yuan910715/3keys/updatepage/a3d5aa0211ee351263de6953c64a4eea.png

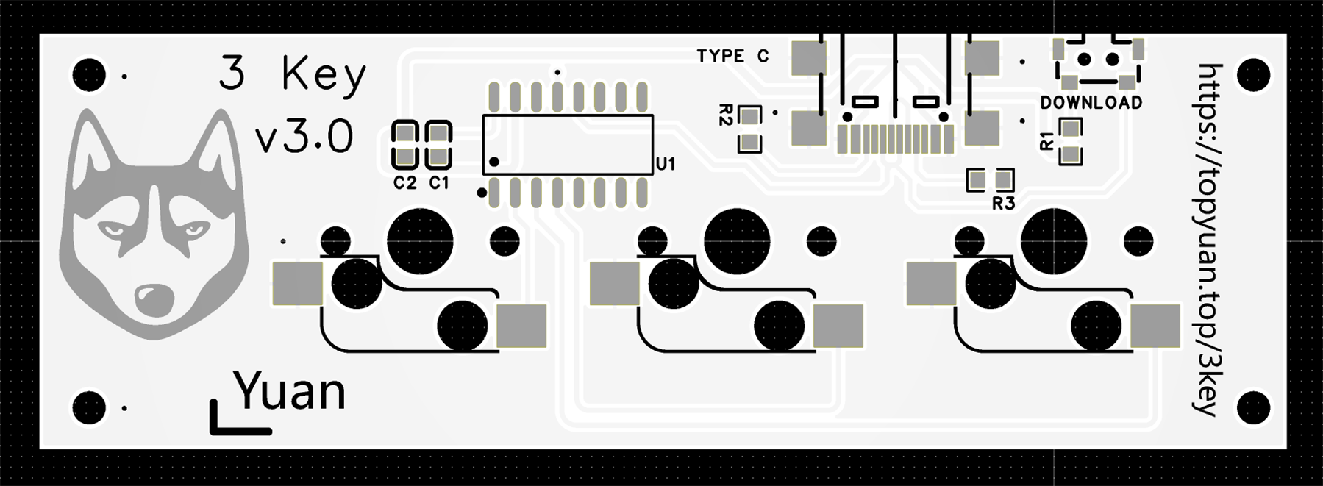
updatepage/a3d5aa0211ee351263de6953c64a4eea.png
