yuan910715/3keys/updatepage/db6b78d11dcdd43cf0e8a59821b84ef4.png

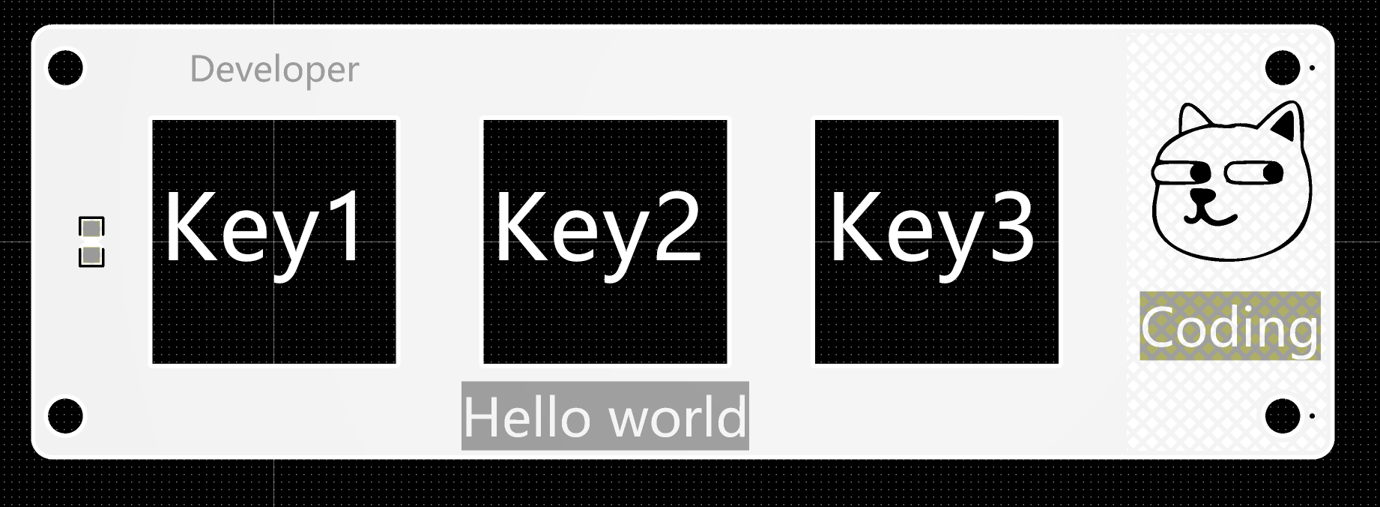
updatepage/db6b78d11dcdd43cf0e8a59821b84ef4.png
