yuan910715/3keys/WindowsFormsApp1/WindowsFormsApp1/Resources/key.png

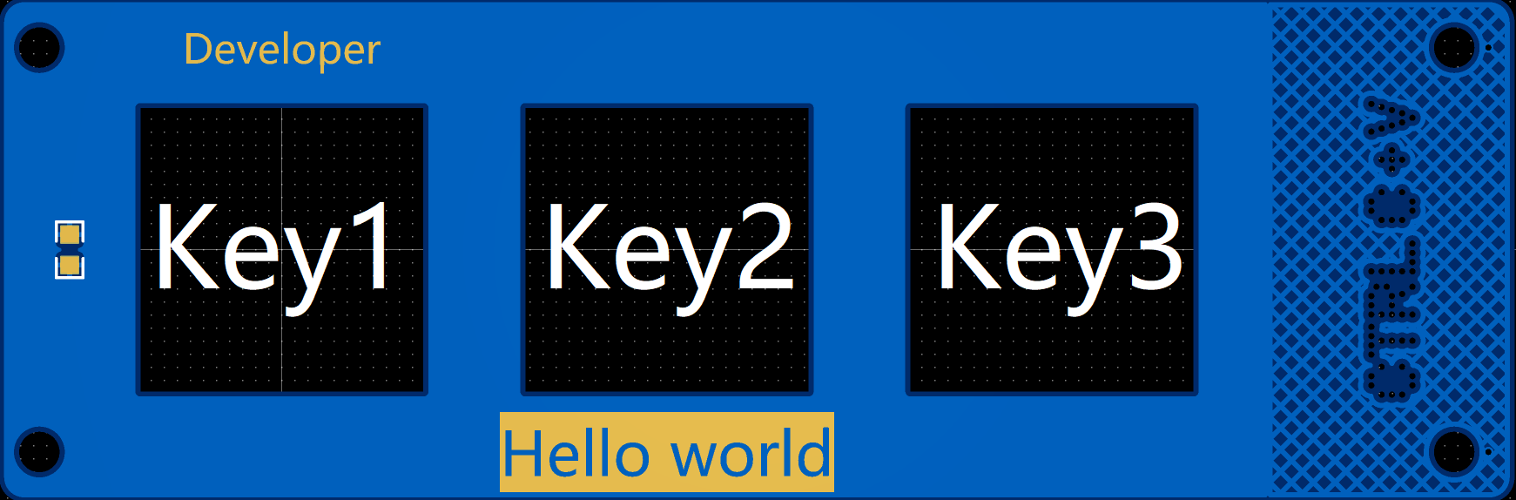
WindowsFormsApp1/WindowsFormsApp1/Resources/key.png
