yuan910715/3keys/(threads)

Thread 1 (2023-03-30):

v4固件下的小键盘，无法通过usb-hub连接电脑

louis16s, 2023-03-30:
排除了type-c线的问题，同样的扩展坞，上一版的固件可以直接使用
v4固件的则没有反应

yuan910715, 2023-03-30:
使用 USB A to C 数据线 还是 C to C 数据线？
不适用扩展坞可否正常连接？

> 排除了type-c线的问题，同样的扩展坞，上一版的固件可以直接使用 v4固件的则没有反应

louis16s, 2023-03-30:
使用a 2 c，直连笔记本可用

Have a nice day
  r祺
________________________________
发件人: MonsterYuan ***@***.***>
发送时间: Thursday, March 30, 2023 4:44:11 PM
收件人: yuan910715/3keys ***@***.***>
抄送: louis16s ***@***.***>; Author ***@***.***>
主题: Re: [yuan910715/3keys] v4固件下的小键盘，无法通过usb-hub连接电脑 (Issue #1)

使用 USB A to C 数据线 还是 C to C 数据线？
不适用扩展坞可否正常连接？

排除了type-c线的问题，同样的扩展坞，上一版的固件可以直接使用 v4固件的则没有反应

―
Reply to this email directly, view it on GitHub<https://github.com/yuan910715/3keys/issues/1#issuecomment-1489923920>, or unsubscribe<https://github.com/notifications/unsubscribe-auth/ANVAEDCFSRCCCYG7Y6EBP2TW6VBVXANCNFSM6AAAAAAWM6YPVQ>.
You are receiving this because you authored the thread.Message ID: ***@***.***>

yuan910715, 2023-03-30:
使用扩展坞连接后, web改键页能否连接设备？ https://topyuan.top/3key

louis16s, 2023-03-30:
抱歉，打扰了
经过多次试验，现在成功通过hub连上了键盘
原因未知
给您带来不便，敬请谅解

Have a nice day
  r祺
________________________________
发件人: MonsterYuan ***@***.***>
发送时间: Thursday, March 30, 2023 4:53:54 PM
收件人: yuan910715/3keys ***@***.***>
抄送: louis16s ***@***.***>; Author ***@***.***>
主题: Re: [yuan910715/3keys] v4固件下的小键盘，无法通过usb-hub连接电脑 (Issue #1)

使用扩展坞连接后, web改键页能否连接设备？ https://topyuan.top/3key

―
Reply to this email directly, view it on GitHub<https://github.com/yuan910715/3keys/issues/1#issuecomment-1489937573>, or unsubscribe<https://github.com/notifications/unsubscribe-auth/ANVAEDDEQ3H2OPUPFGUWZBLW6VC2FANCNFSM6AAAAAAWM6YPVQ>.
You are receiving this because you authored the thread.Message ID: ***@***.***>

yuan910715, 2023-03-30:
插上USB线后 需要等待2秒再操作键盘
如果刚插上就立刻按键 会导致键盘按键不可用，但此时改键可正常连接. 这个问题原因未知。怀疑是这个问题导致。

yuan910715, 2023-04-25:
>
V4.1已解决此问题
https://github.com/DeqingSun/ch55xduino/issues/132

Closed 2023-03-30.

Thread 2 (2023-04-30):

请教一下HID的问题

hanbingniao, 2023-04-30:
你好！从deqingsun大大的issues看到了您，正好也是做类似的东西，然后看到那个cdc的项目是声明的HID键盘，但是我想用媒体键盘，但是对HID不太熟u，改了一下午，请教一下那个reportID要怎么改呀？现在合并完了虽然能编译但是按键用不了，看到您实现了，想请教一下，谢谢！

yuan910715, 2023-05-04:
看下我的代码， 是CDC+多媒体键盘的。就是reportID要和desc里的对应就行

hanbingniao, 2023-07-07:
仔细研究了一下，非常感谢！！
最近也在做ch552的小键盘，算是单片机初学，还有有很多不懂的哈哈哈
然后能在我的项目里用一下您的src的文件吗？谢谢！

yuan910715, 2023-07-17:
>

可以

Closed 2023-07-17.

Thread 5 (2023-07-16):

HID键盘扩展请求

Zylsjsp, 2023-07-16:
你好 从立创广场一路看到这来的 很不错的3键键盘固件！

我自己的出发点是想要做一个单独的Sysreq单键键盘 开源广场上也看了很多方案 感觉各路神仙都把ch552玩出花来

我读了@DeqingSun的示例代码和你的项目 基于我自己的使用场景 想给功能键增加一个sysreq的选项 也查了相关的hid规范pdf
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
感觉只要在`USBHIDKeyboard.c`修改`#DEFINE`和`app.vue`里面的列表应该就能加入新的键位 板子和材料还没到所以我暂时还不能验证可行性 如果可行的话看看能不能接受一下我的PR

可以的话能不能尝试对HID里面的其他键进行扩展呢 比如留一部分自定义功能键`0xfc-0xfe`可以提供给自定义的映射 至少有三个键的空间可以用 如果可以把这三个键在web改键程序上作为自定义扩展提供应该会更加方便（例如需要改PrintScr, Pause键的场景）

yuan910715, 2023-07-17:
添加按键很容易，USBHIDKeyboard.c里可以不修改。
Sysreq按键是什么作用？我查了资料现代键盘已没有此键位  部分操作系统将其解析成PrintScreen ，你是想要添加PrintScreen按键吗？

Zylsjsp, 2023-07-17:
Sysreq的功能可以参考内核文档[Linux Magic System Request Key Hacks](https://www.kernel.org/doc/html/latest/admin-guide/sysrq.html)

有一部分键盘厂商是将printsrc和sysreq做到一个键上的 但是这个方法不在USB HID的规范中 同时这个键的位置在表里的位置太靠后了 @DeqingSun提供的示例代码中给出的+136的映射区域不能够直接找到HID中后半部分的键（中间`0xb5`我记得也是一个跳过去的映射 因为和'~'冲突吧好像） 看看是不是有机会可以考虑重构一下这部分代码完整支持HID keyboard的完整表

另外 这个键盘支持6键无冲吗 如果不支持的话是不是最好也做一个适配

yuan910715, 2023-07-20:
我在改键页增加了printscr/break pause/num lock/scroll lock四个按键， sysreq我再研究下。 CH552 IO够 可以6键无冲不需要添加其他元件。

Thread 6 (2023-07-17):

代码

Mr-ShiYi, 2023-07-17:
请问，v5.1码源能发一下吗，我想改个连接名称

Zylsjsp, 2023-07-17:
@yuan910715 看了一下commit记录 可以考虑去了解一下git的使用方法 本地git仓库修改了之后可以git push和GitHub同步 省去单独上传的麻烦了

命令行工具不好上手的话可以考虑一下vscode git插件 非常直观好用

yuan910715, 2023-07-20:
5.1源码已上传。

> 请问，v5.1码源能发一下吗，我想改个连接名称

yuan910715, 2023-07-20:
> @yuan910715 看了一下commit记录 可以考虑去了解一下git的使用方法 本地git仓库修改了之后可以git push和GitHub同步 省去单独上传的麻烦了
>
> 命令行工具不好上手的话可以考虑一下vscode git插件 非常直观好用

公司的网络有限制，git push跑不了 我就直接web页面上传了。

Mr-ShiYi, 2023-07-20:
好的，谢谢

Mr-ShiYi, 2023-07-20:
> 5.1源码已上传。
>
> > 请问，v5.1码源能发一下吗，我想改个连接名称

@yuan910715 请问0x0317和0x030e两个代码什么意思，我知道0x0316是改连接名称的
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

yuan910715, 2023-07-20:
>

是CDC的描述信息 但windows不会显示

Mr-ShiYi, 2023-07-20:
好的，谢谢，那我可以不管他，只改0316

Closed 2023-07-20.

Thread 7 (2023-07-20):

dataflash数据存储问题

LUCA-5342, 2023-07-20:
您好，我注意到CH552G芯片内置的dataflash只有128K，dedingsun的eeprom.h中也描述到if (addr >= 128) {
    return;
  }，看您的板子并没有增加外置存储，想请问您是如何做到eeprom读写到152地址的呢，是否能更多？
顺带一提，把鼠标加进来太棒了，可惜源码中并没有~

yuan910715, 2023-07-20:
您好 纠正一下CH552G芯片内置的dataflash是128字节 不是128K  之前我没注意到 所以有大于128的 实际重新插拔USB线后这部分设置就丢失了-_-||
我把最新源码上传了 包含鼠标部分了。
现在保存设置很多项是按1字节保存 实际用不了这么多  改为按位拼接保存 会省一些空间。

LUCA-5342, 2023-07-20:
感谢回答，之前就想做这个，但一直没有时间，最近抽空鼓捣了一下，结果需要近300字节的eeprom才够，查看报文发现128之后开始循环了，准备考虑一下按位拼接保存！

Closed 2023-08-04.

Thread 9 (2023-10-21):

大佬，我代码有点不懂，指导一下，谢谢

Mr-ShiYi, 2023-10-21:
请问，按键判断条件代码我有点不懂，能不能跟我解释一下，就是if的判断条件不是很懂，我试着代进去，还是，有一点弯没转过来
图片是示例里来的，
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

Mr-ShiYi, 2023-10-21:
@yuan910715 有空就帮我指导一下，谢谢

yuan910715, 2023-10-25:
就是判断按键按下或弹起状态有没有改变

yuan910715, 2023-10-25:
`bool button1PressPrev = false;`
button1PressPrev在loop外定义 值为false  表示key1默认状态为弹起状态。 此变量用于标识按键上次改变后的状态。

`bool button1Press = !digitalRead(BUTTON1_PIN);`
button1Press表示key1当前状态 弹起为false 按下为true  ，digitalRead读取按键1的引脚值（HIGH或LOW  (1/0) ）由于硬件上key1的键盘轴连接对应引脚和GND  且引脚配置了内部上拉 参考setup()中：pinMode(BUTTON1_PIN, INPUT_PULLUP);   所以digitalRead读取此引脚 当键盘轴弹起状态为HIGH(1-true) ， 按下为LOW(0-false)  取反后，键盘弹起为false 按下为true

if里就是用key1上次改变后的状态button1PressPrev和当前状态button1Press判断 不等于时表明状态发生改变。

Mr-ShiYi, 2023-10-25:
就是布尔值button1PressPrev = false是一个记录按键上一次状态
比如button1PressPrev = false，按下按钮当前状态取反为ture，两者不相等，执行if，将当前状态赋予button1PressPrev = false变为ture

yuan910715, 2023-10-25:
是的 就是这意思

Mr-ShiYi, 2023-10-25:
谢谢，懂了，还有就是，我想加键的话，代码按照上面示例加就行是吧，相当于固定输出，不能自定义按键

yuan910715, 2023-10-25:
是的

Mr-ShiYi, 2023-10-25:
好的，谢谢指导

Closed 2023-10-25.

Thread 12 (2024-04-26):

HID按键2个问题？

wuqi716, 2024-04-26:
1、请教楼主，XP,WIN7系统不装驱动都支持吗？

2、如果按键按下状态（一直按着），怎么能每1秒循环发送键值？请教楼主

yuan910715, 2024-04-26:
WIN 7试过，键盘可用，改键需要安装USB CDC驱动，XP没有试过。
Keyboard_press和Keyboard_release分别为按键按下、释放方法，如果一直按着，操作系统会控制一直输出相应按键，如果想手动每隔1秒触发一次，延时控制就行。

wuqi716, 2024-04-26:
收到，谢谢，改键需要安装USB CDC驱动意思是在电脑上安装，还是在Arduino里插入代码编译生成HEX程序？&nbsp;

吴先生
***@***.***

&nbsp;

------------------&nbsp;原始邮件&nbsp;------------------
发件人: ***@***.***&gt;;
发送时间: 2024年4月26日(星期五) 上午10:23
收件人: ***@***.***&gt;;
抄送: ***@***.***&gt;; ***@***.***&gt;;
主题: Re: [yuan910715/3keys] HID按键2个问题？ (Issue #12)

WIN 7试过，键盘可用，改键需要安装USB CDC驱动，XP没有试过。
 Keyboard_press和Keyboard_release分别为按键按下、释放方法，如果一直按着，操作系统会控制一直输出相应按键，如果想手动每隔1秒触发一次，延时控制就行。

—
Reply to this email directly, view it on GitHub, or unsubscribe.
You are receiving this because you authored the thread.Message ID: ***@***.***&gt;

yuan910715, 2024-04-26:
需要在WIN 7的PC上安装USB CDC驱动，否则可能不会识别USB串口设备，导致改键页面不能搜到设备

wuqi716, 2024-04-26:
收到，谢谢，我试试

&nbsp;

吴先生
***@***.***

&nbsp;

------------------&nbsp;原始邮件&nbsp;------------------
发件人: ***@***.***&gt;;
发送时间: 2024年4月26日(星期五) 上午10:32
收件人: ***@***.***&gt;;
抄送: ***@***.***&gt;; ***@***.***&gt;;
主题: Re: [yuan910715/3keys] HID按键2个问题？ (Issue #12)

需要在WIN 7的PC上安装USB CDC驱动，否则可能不会识别USB串口设备，导致改键页面不能搜到设备

—
Reply to this email directly, view it on GitHub, or unsubscribe.
You are receiving this because you authored the thread.Message ID: ***@***.***&gt;

Closed 2024-04-26.

Thread 13 (2024-06-14):

编译失败

xiaoWangSec, 2024-06-14:
```
Linking everything together...
"C:\\Users\\Administrator\\AppData\\Local\\Arduino15\\packages\\CH55xDuino\\tools\\MCS51Tools\\2023.10.10/win/busybox" ash "C:\\Users\\Administrator\\AppData\\Local\\Arduino15\\packages\\CH55xDuino\\tools\\MCS51Tools\\2023.10.10/wrapper/sdcc-link.sh" "C:\\Users\\Administrator\\AppData\\Local\\Arduino15\\packages\\CH55xDuino\\tools\\sdcc\\build.13407_4/bin/sdcc" --nostdlib "-LC:\\Users\\Administrator\\AppData\\Local\\Temp\\arduino\\sketches\\33BDE724B82CB71055F8934B06EEDA5C" "-LC:\\Users\\Administrator\\AppData\\Local\\Arduino15\\packages\\CH55xDuino\\tools\\sdcc\\build.13407_4/lib/large_int_calc_stack_auto" --code-size 14336 --xram-size 876 --xram-loc 148 -mmcs51 -DCH552 "C:\\Users\\Administrator\\AppData\\Local\\Temp\\arduino\\sketches\\33BDE724B82CB71055F8934B06EEDA5C\\sketch\\threekey.ino.cpp.o" "C:\\Users\\Administrator\\AppData\\Local\\Temp\\arduino\\sketches\\33BDE724B82CB71055F8934B06EEDA5C\\sketch\\src\\CDC_KEYBOARD\\USBCDC.c.o" "C:\\Users\\Administrator\\AppData\\Local\\Temp\\arduino\\sketches\\33BDE724B82CB71055F8934B06EEDA5C\\sketch\\src\\CDC_KEYBOARD\\USBHIDKeyboard.c.o" "C:\\Users\\Administrator\\AppData\\Local\\Temp\\arduino\\sketches\\33BDE724B82CB71055F8934B06EEDA5C\\sketch\\src\\CDC_KEYBOARD\\USBconstant.c.o" "C:\\Users\\Administrator\\AppData\\Local\\Temp\\arduino\\sketches\\33BDE724B82CB71055F8934B06EEDA5C\\sketch\\src\\CDC_KEYBOARD\\USBhandler.c.o" "C:\\Users\\Administrator\\AppData\\Local\\Temp\\arduino\\sketches\\33BDE724B82CB71055F8934B06EEDA5C/core\\core.a" -lmcs51 -llibsdcc -lliblong -lliblonglong -llibint -llibfloat --out-fmt-ihx -o "C:\\Users\\Administrator\\AppData\\Local\\Temp\\arduino\\sketches\\33BDE724B82CB71055F8934B06EEDA5C/threekey.ino.elf"

?ASlink-Error-Insufficient ROM/EPROM/FLASH memory.
"C:\\Users\\Administrator\\AppData\\Local\\Arduino15\\packages\\CH55xDuino\\tools\\sdcc\\build.13407_4/bin/avr-objcopy_7_3_0" -O ihex -R DATA -R INITIALIZED -R SSEG "C:\\Users\\Administrator\\AppData\\Local\\Temp\\arduino\\sketches\\33BDE724B82CB71055F8934B06EEDA5C/threekey.ino.elf" "C:\\Users\\Administrator\\AppData\\Local\\Temp\\arduino\\sketches\\33BDE724B82CB71055F8934B06EEDA5C/threekey.ino.hex"
C:\Users\Administrator\AppData\Local\Arduino15\packages\CH55xDuino\tools\sdcc\build.13407_4/bin/avr-objcopy_7_3_0: 'C:\Users\Administrator\AppData\Local\Temp\arduino\sketches\33BDE724B82CB71055F8934B06EEDA5C/threekey.ino.elf': No such file

exit status 1

Compilation error: exit status 1

```

xiaoWangSec, 2024-06-14:
安装0.0.16版本的CH55x开发板成功编译

Closed 2024-06-14.

Thread 14 (2024-07-11):

关于换行符的问题

sanbrother, 2024-07-11:
请问下，在网页上，可以在字符串后面添加换行符吗？
比如说HELLO\n，结果会把\n输出，而不是期待的换行

谢谢

yuan910715, 2024-07-12:
已增加，请帮助测试

sanbrother, 2024-07-14:
收到，非常感谢。测试后反馈结果

sanbrother, 2024-07-14:
> 已增加，请帮助测试
确认完成，非常好用。您增加的回车选项真的方便，我原本以为会处理成转义符，那样还真挺麻烦。
感谢您开源的作品，太好用了

sanbrother, 2024-07-14:
再次感谢

Closed 2024-07-14.

Thread 15 (2024-07-31):

关于数字锁定，滚轮锁定和空格键的问题

Mr-ShiYi, 2024-07-31:
你好，我在ch552的例程库文件里没有看见关于这三个按键，能告诉我是哪个对应这三个按键吗

yuan910715, 2024-07-31:
Scroll Lock : 0xCF
Num Lock : 0xDB
空格键是ASCII码0x20

Mr-ShiYi, 2024-07-31:
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
请问，怎么利用这个程序使用这些按键，直接用ascl码吗

yuan910715, 2024-07-31:
参考Keyboard_press(0x20)

Mr-ShiYi, 2024-07-31:
在那可以看正确的ASCLL码，我在网上搜的对应不上

Closed 2024-07-31.

Thread 16 (2024-11-01):

关于模拟鼠标

BD3OOX, 2024-11-01:
ok

BD3OOX, 2024-11-05:
@ @ @

yuan910715, 2024-11-05:
你好 没复现问题 请详细描述一下设置过程

BD3OOX, 2024-11-05:
第一次:设置成 鼠标 长按按住鼠标,保存
第二次,鼠标 向上移动,保存
第三次,改回第一次的配置
这样就变成长按+移动了

yuan910715, 2024-11-05:
已修复，请重新刷入7.0测试

BD3OOX, 2024-11-05:
实际一直有个问题,没多问,github下载的hex固件,WCHISP都会提示hex转bin失败,从你网站下的没事,我自己编译的也没事

Closed 2024-11-12.

Thread 17 (2025-03-18):

固件烧写问题

sanbrother, 2025-03-18:
今天尝试烧写V7版本的固件，WCHISPStudio提示目标文件HEX转BIN失败
使用hex2bin转换成bin后，烧写成功了

以前烧写hex文件是没有问题的，奇怪了。尝试了V6版本也不行

yuan910715, 2025-03-18:
你好，不能烧录的hex是github里的吗？
请试下https://topyuan.top/3key/howtoupdate 下载的hex是否可以正常烧录

sanbrother, 2025-03-19:
> 你好，不能烧录的hex是github里的吗？ 请试下https://topyuan.top/3key/howtoupdate 下载的hex是否可以正常烧录
噢，github里面带的不好用。howtoupdate里面的OK，谢谢

yuan910715, 2025-03-19:
> > 你好，不能烧录的hex是github里的吗？ 请试下https://topyuan.top/3key/howtoupdate 下载的hex是否可以正常烧录
>
> 噢，github里面带的不好用。howtoupdate里面的OK，谢谢

我把github的压缩了一下 应该没问题了 你可以试试 不知道为什么hex不行  感谢!

Closed 2025-03-19.

Thread 18 (2025-03-26):

库中的代码，在我本地编译不过求帮忙。

humanpp, 2025-03-26:
FQBN: CH55xDuino:mcs51:ch552:usb_settings=user148
Using board 'ch552' from platform in folder: C:\Users\users1\AppData\Local\Arduino15\packages\CH55xDuino\hardware\mcs51\0.0.23
Using core 'ch55xduino' from platform in folder: C:\Users\users1\AppData\Local\Arduino15\packages\CH55xDuino\hardware\mcs51\0.0.23

Detecting libraries used...
C:\Users\users1\AppData\Local\Arduino15\packages\CH55xDuino\tools\MCS51Tools\2023.10.10/win/busybox ash C:\Users\users1\AppData\Local\Arduino15\packages\CH55xDuino\tools\MCS51Tools\2023.10.10/wrapper/sdcc.sh C:\Users\users1\AppData\Local\Arduino15\packages\CH55xDuino\tools\sdcc\build.13407_4/bin/sdcc C:\Users\users1\AppData\Local\arduino\sketches\02FDFFE97B6386BD774A75BC1CEE9C95\sketch\threekey.ino.cpp nul re12 -c -Ddouble=float -DUSE_STDINT -D__PROG_TYPES_COMPAT__ --model-large --int-long-reent -E -MC -mmcs51 -DCH552 -DF_CPU=24000000L -DF_EXT_OSC=0L -DARDUINO=10607 -DARDUINO_ch55x -DARDUINO_ARCH_MCS51 -DUSER_USB_RAM=148 -IC:\Users\users1\AppData\Local\Arduino15\packages\CH55xDuino\hardware\mcs51\0.0.23\cores\ch55xduino -IC:\Users\users1\AppData\Local\Arduino15\packages\CH55xDuino\hardware\mcs51\0.0.23\variants\ch552 -IC:\Users\users1\AppData\Local\Arduino15\packages\CH55xDuino\tools\sdcc\build.13407_4/include
Using cached library dependencies for file: C:\Users\users1\AppData\Local\arduino\sketches\02FDFFE97B6386BD774A75BC1CEE9C95\sketch\src\CDC_KEYBOARD\USBCDC.c
Using cached library dependencies for file: C:\Users\users1\AppData\Local\arduino\sketches\02FDFFE97B6386BD774A75BC1CEE9C95\sketch\src\CDC_KEYBOARD\USBHIDKeyboard.c
Using cached library dependencies for file: C:\Users\users1\AppData\Local\arduino\sketches\02FDFFE97B6386BD774A75BC1CEE9C95\sketch\src\CDC_KEYBOARD\USBconstant.c
Using cached library dependencies for file: C:\Users\users1\AppData\Local\arduino\sketches\02FDFFE97B6386BD774A75BC1CEE9C95\sketch\src\CDC_KEYBOARD\USBhandler.c
Generating function prototypes...
C:\Users\users1\AppData\Local\Arduino15\packages\CH55xDuino\tools\MCS51Tools\2023.10.10/win/busybox ash C:\Users\users1\AppData\Local\Arduino15\packages\CH55xDuino\tools\MCS51Tools\2023.10.10/wrapper/sdcc.sh C:\Users\users1\AppData\Local\Arduino15\packages\CH55xDuino\tools\sdcc\build.13407_4/bin/sdcc C:\Users\users1\AppData\Local\arduino\sketches\02FDFFE97B6386BD774A75BC1CEE9C95\sketch\threekey.ino.cpp C:\Users\users1\AppData\Local\Temp\3940619350\sketch_merged.cpp re12 -c -Ddouble=float -DUSE_STDINT -D__PROG_TYPES_COMPAT__ --model-large --int-long-reent -E -MC -mmcs51 -DCH552 -DF_CPU=24000000L -DF_EXT_OSC=0L -DARDUINO=10607 -DARDUINO_ch55x -DARDUINO_ARCH_MCS51 -DUSER_USB_RAM=148 -IC:\Users\users1\AppData\Local\Arduino15\packages\CH55xDuino\hardware\mcs51\0.0.23\cores\ch55xduino -IC:\Users\users1\AppData\Local\Arduino15\packages\CH55xDuino\hardware\mcs51\0.0.23\variants\ch552 -IC:\Users\users1\AppData\Local\Arduino15\packages\CH55xDuino\tools\sdcc\build.13407_4/include
C:\Users\users1\AppData\Local\Arduino15\packages\builtin\tools\ctags\5.8-arduino11/ctags -u --language-force=c++ -f - --c++-kinds=svpf --fields=KSTtzns --line-directives C:\Users\users1\AppData\Local\Temp\3940619350\sketch_merged.cpp
Compiling sketch...
"C:\\Users\\users1\\AppData\\Local\\Arduino15\\packages\\CH55xDuino\\tools\\MCS51Tools\\2023.10.10/win/busybox" ash "C:\\Users\\users1\\AppData\\Local\\Arduino15\\packages\\CH55xDuino\\tools\\MCS51Tools\\2023.10.10/wrapper/sdcc.sh" "C:\\Users\\users1\\AppData\\Local\\Arduino15\\packages\\CH55xDuino\\tools\\sdcc\\build.13407_4/bin/sdcc" "C:\\Users\\users1\\AppData\\Local\\arduino\\sketches\\02FDFFE97B6386BD774A75BC1CEE9C95\\sketch\\threekey.ino.cpp" "C:\\Users\\users1\\AppData\\Local\\arduino\\sketches\\02FDFFE97B6386BD774A75BC1CEE9C95\\sketch\\threekey.ino.cpp.o" re2 -MMD -c -Ddouble=float -DUSE_STDINT -D__PROG_TYPES_COMPAT__ --model-large --int-long-reent --less-pedantic -mmcs51 -DCH552 -DF_CPU=24000000L -DF_EXT_OSC=0L -DARDUINO=10607 -DARDUINO_ch55x -DARDUINO_ARCH_MCS51 -DUSER_USB_RAM=148 "-IC:\\Users\\users1\\AppData\\Local\\Arduino15\\packages\\CH55xDuino\\hardware\\mcs51\\0.0.23\\cores\\ch55xduino" "-IC:\\Users\\users1\\AppData\\Local\\Arduino15\\packages\\CH55xDuino\\hardware\\mcs51\\0.0.23\\variants\\ch552" "-IC:\\Users\\users1\\AppData\\Local\\Arduino15\\packages\\CH55xDuino\\tools\\sdcc\\build.13407_4/include"
Using previously compiled file: C:\Users\users1\AppData\Local\arduino\sketches\02FDFFE97B6386BD774A75BC1CEE9C95\sketch\src\CDC_KEYBOARD\USBconstant.c.o
Using previously compiled file: C:\Users\users1\AppData\Local\arduino\sketches\02FDFFE97B6386BD774A75BC1CEE9C95\sketch\src\CDC_KEYBOARD\USBhandler.c.o
Using previously compiled file: C:\Users\users1\AppData\Local\arduino\sketches\02FDFFE97B6386BD774A75BC1CEE9C95\sketch\src\CDC_KEYBOARD\USBHIDKeyboard.c.o
Using previously compiled file: C:\Users\users1\AppData\Local\arduino\sketches\02FDFFE97B6386BD774A75BC1CEE9C95\sketch\src\CDC_KEYBOARD\USBCDC.c.o
Compiling libraries...
Compiling core...
Using precompiled core: C:\Users\users1\AppData\Local\arduino\cores\aadd0a0b637199e1f6a6e80db97698d7\core.a
Linking everything together...
"C:\\Users\\users1\\AppData\\Local\\Arduino15\\packages\\CH55xDuino\\tools\\MCS51Tools\\2023.10.10/win/busybox" ash "C:\\Users\\users1\\AppData\\Local\\Arduino15\\packages\\CH55xDuino\\tools\\MCS51Tools\\2023.10.10/wrapper/sdcc-link.sh" "C:\\Users\\users1\\AppData\\Local\\Arduino15\\packages\\CH55xDuino\\tools\\sdcc\\build.13407_4/bin/sdcc" --nostdlib "-LC:\\Users\\users1\\AppData\\Local\\arduino\\sketches\\02FDFFE97B6386BD774A75BC1CEE9C95" "-LC:\\Users\\users1\\AppData\\Local\\Arduino15\\packages\\CH55xDuino\\tools\\sdcc\\build.13407_4/lib/large_int_calc_stack_auto" --code-size 14336 --xram-size 876 --xram-loc 148 -mmcs51 -DCH552 "C:\\Users\\users1\\AppData\\Local\\arduino\\sketches\\02FDFFE97B6386BD774A75BC1CEE9C95\\sketch\\threekey.ino.cpp.o" "C:\\Users\\users1\\AppData\\Local\\arduino\\sketches\\02FDFFE97B6386BD774A75BC1CEE9C95\\sketch\\src\\CDC_KEYBOARD\\USBCDC.c.o" "C:\\Users\\users1\\AppData\\Local\\arduino\\sketches\\02FDFFE97B6386BD774A75BC1CEE9C95\\sketch\\src\\CDC_KEYBOARD\\USBHIDKeyboard.c.o" "C:\\Users\\users1\\AppData\\Local\\arduino\\sketches\\02FDFFE97B6386BD774A75BC1CEE9C95\\sketch\\src\\CDC_KEYBOARD\\USBconstant.c.o" "C:\\Users\\users1\\AppData\\Local\\arduino\\sketches\\02FDFFE97B6386BD774A75BC1CEE9C95\\sketch\\src\\CDC_KEYBOARD\\USBhandler.c.o" "C:\\Users\\users1\\AppData\\Local\\arduino\\sketches\\02FDFFE97B6386BD774A75BC1CEE9C95/..\\..\\cores\\aadd0a0b637199e1f6a6e80db97698d7\\core.a" -lmcs51 -llibsdcc -lliblong -lliblonglong -llibint -llibfloat --out-fmt-ihx -o "C:\\Users\\users1\\AppData\\Local\\arduino\\sketches\\02FDFFE97B6386BD774A75BC1CEE9C95/threekey.ino.elf"

?ASlink-Error-Insufficient ROM/EPROM/FLASH memory.
"C:\\Users\\users1\\AppData\\Local\\Arduino15\\packages\\CH55xDuino\\tools\\sdcc\\build.13407_4/bin/avr-objcopy_7_3_0" -O ihex -R DATA -R INITIALIZED -R SSEG "C:\\Users\\users1\\AppData\\Local\\arduino\\sketches\\02FDFFE97B6386BD774A75BC1CEE9C95/threekey.ino.elf" "C:\\Users\\users1\\AppData\\Local\\arduino\\sketches\\02FDFFE97B6386BD774A75BC1CEE9C95/threekey.ino.hex"
C:\Users\users1\AppData\Local\Arduino15\packages\CH55xDuino\tools\sdcc\build.13407_4/bin/avr-objcopy_7_3_0: 'C:\Users\users1\AppData\Local\arduino\sketches\02FDFFE97B6386BD774A75BC1CEE9C95/threekey.ino.elf': No such file

exit status 1

Compilation error: exit status 1

问了deepseek说是内存不够？

humanpp, 2025-03-26:
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

代码就是原版未动，直接编译。

yuan910715, 2025-03-26:
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

yuan910715, 2025-03-26:
请按上图尝试调整 Tools-USB Settings值

humanpp, 2025-04-03:
多谢大佬

Closed 2025-04-03.
