yuan910715/3keys/threekey/src/CDC_KEYBOARD/USBconstant.c

#include "USBconstant.h"


//Device descriptor
__code uint8_t DevDesc[] = {
    0x12,0x01,
    0x10,0x01,  //USB spec release number in BCD format, USB1.1 (0x10, 0x01).
    0xEF,0x02,0x01, //bDeviceClass, bDeviceSubClass, bDeviceProtocol 
    DEFAULT_ENDP0_SIZE, //bNumConfigurations
    0x09,0x12,0x50,0xC5, // VID PID 
    0x01,0x01,  //version
    0x01,0x02,0x03, //bString
    0x01    //bNumConfigurations
};

__code uint16_t DevDescLen = sizeof(DevDesc);

__code uint8_t CfgDesc[] ={
    0x09,0x02,sizeof(CfgDesc) & 0xff,sizeof(CfgDesc) >> 8,
    0x03,0x01,0x00,0x80,0x64,             //Configuration descriptor (2 interfaces)
    // Interface Association Descriptor, IAD, this packes following 2 interfaces into 1
    0x08,0x0B,0x00,0x02,0x02,0x02,0x01,0x04,
    // Interface 1 (CDC) descriptor
    0x09,0x04,0x00,0x00,0x01,0x02,0x02,0x01,0x04,    // CDC control description, 1 endpoint
    // Functional Descriptor refer to usbcdc11.pdf
    0x05,0x24,0x00,0x10,0x01,                                 //Header Functional Descriptor
    0x05,0x24,0x01,0x00,0x00,                                 //Call Management Functional Descriptor
    0x04,0x24,0x02,0x02,                                      //Direct Line Management Functional Descriptor, Support: Set_Line_Coding, Set_Control_Line_State, Get_Line_Coding, Serial_State 
    0x05,0x24,0x06,0x00,0x01,                                 //Union Functional Descriptor, Communication class interface 0, Data Class Interface 1
    0x07,0x05,0x81,0x03,0x08,0x00,0x40,                       //EndPoint descriptor (CDC Upload, Interrupt)
    // Interface 2 (Data Interface) descriptor
    0x09,0x04,0x01,0x00,0x02,0x0a,0x00,0x00,0x04,             //Data Class Interface descriptor
    0x07,0x05,0x02,0x02,0x40,0x00,0x00,                       //endpoint descriptor
    0x07,0x05,0x82,0x02,0x40,0x00,0x00,                       //endpoint descriptor
     // Interface 3 (HID) descriptor
    0x09,0x04,0x02,0x00,0x01,0x03,0x01,0x01,0x00,    // HID Keyboard, 2 endpoints
    0x09,0x21,0x10,0x01,0x21,0x01,0x22,sizeof(ReportDesc) & 0xff,sizeof(ReportDesc) >> 8,    //HID Descriptor
    0x07,0x05,0x83,0x03,0x10,0x00,0x0A,                       //endpoint descriptor
   
};

__code uint16_t ReportDescLen = sizeof(ReportDesc);

__code uint8_t ReportDesc[] ={
    0x05, 0x01,                    // USAGE_PAGE (Generic Desktop)
    0x09, 0x06,                    // USAGE (Keyboard)
    0xa1, 0x01,                    // COLLECTION (Application)
 0x85, 0x01,                    //   REPORT_ID (1)
    0x05, 0x07,                    //   USAGE_PAGE (Keyboard)
    0x19, 0xe0,                    //   USAGE_MINIMUM (Keyboard LeftControl)
    0x29, 0xe7,                    //   USAGE_MAXIMUM (Keyboard Right GUI)
    0x15, 0x00,                    //   LOGICAL_MINIMUM (0)
    0x25, 0x01,                    //   LOGICAL_MAXIMUM (1)
    0x95, 0x08,                    //   REPORT_COUNT (8)
    0x75, 0x01,                    //   REPORT_SIZE (1)
    0x81, 0x02,                    //   INPUT (Data,Var,Abs)
    0x95, 0x01,                    //   REPORT_COUNT (1)
    0x75, 0x08,                    //   REPORT_SIZE (8)
    0x81, 0x03,                    //   INPUT (Cnst,Var,Abs)
    0x95, 0x06,                    //   REPORT_COUNT (6)
    0x75, 0x08,                    //   REPORT_SIZE (8)
    0x15, 0x00,                    //   LOGICAL_MINIMUM (0)
 0x26, 0xff, 0x00,              //   LOGICAL_MAXIMUM (255)
    0x05, 0x07,                    //   USAGE_PAGE (Keyboard)
    0x19, 0x00,                    //   USAGE_MINIMUM (Reserved (no event indicated))
    0x29, 0xe7,                    //   USAGE_MAXIMUM (Keyboard Right GUI)
    0x81, 0x00,                    //   INPUT (Data,Ary,Abs)
    0x05, 0x08,                    //   USAGE_PAGE (LEDs)
    0x19, 0x01,                    //   USAGE_MINIMUM (Num Lock)
    0x29, 0x05,                    //   USAGE_MAXIMUM (Kana)
    0x15, 0x00,                    //   LOGICAL_MINIMUM (0)
    0x25, 0x01,                    //   LOGICAL_MAXIMUM (1)
    0x95, 0x05,                    //   REPORT_COUNT (5)
    0x75, 0x01,                    //   REPORT_SIZE (1)
    0x91, 0x02,                    //   OUTPUT (Data,Var,Abs)
    0x95, 0x01,                    //   REPORT_COUNT (1)
    0x75, 0x03,                    //   REPORT_SIZE (3)
    0x91, 0x03,                    //   OUTPUT (Cnst,Var,Abs)
 0xc0,                          // END_COLLECTION
    0x05, 0x0c,                    // USAGE_PAGE (Consumer Devices)
    0x09, 0x01,                    // USAGE (Consumer Control)
    0xa1, 0x01,                    // COLLECTION (Application)
    0x85, 0x02,                    //   REPORT_ID (2)
    0x15, 0x00,                    //   LOGICAL_MINIMUM (0)
    0x26, 0xff, 0x03,              //   LOGICAL_MAXIMUM (1023)
    0x19, 0x00,                    //   USAGE_MINIMUM (Unassigned)
    0x2a, 0xff, 0x03,              //   USAGE_MAXIMUM (Undefined)
    0x95, 0x04,                    //   REPORT_COUNT (4)
    0x75, 0x10,                    //   REPORT_SIZE (16)
    0x81, 0x00,                    //   INPUT (Data,Ary,Abs)
    0xc0,                           // END_COLLECTION
     0x05, 0x01,                    // USAGE_PAGE (Generic Desktop)
    0x09, 0x02,                    // USAGE (Mouse)
    0xa1, 0x01,                    // COLLECTION (Application)
    0x09, 0x01,                    //   USAGE (Pointer)
    0xa1, 0x00,                    //   COLLECTION (Physical)
    0x85, 0x03,                    //   REPORT_ID (2)
    0x05, 0x09,                    //     USAGE_PAGE (Button)
    0x19, 0x01,                    //     USAGE_MINIMUM (Button 1)
    0x29, 0x03,                    //     USAGE_MAXIMUM (Button 3)
    0x15, 0x00,                    //     LOGICAL_MINIMUM (0)
    0x25, 0x01,                    //     LOGICAL_MAXIMUM (1)
    0x95, 0x03,                    //     REPORT_COUNT (3)
    0x75, 0x01,                    //     REPORT_SIZE (1)
    0x81, 0x02,                    //     INPUT (Data,Var,Abs)
    0x95, 0x01,                    //     REPORT_COUNT (1)
    0x75, 0x05,                    //     REPORT_SIZE (5)
    0x81, 0x03,                    //     INPUT (Cnst,Var,Abs)
    0x05, 0x01,                    //     USAGE_PAGE (Generic Desktop)
    0x09, 0x30,                    //     USAGE (X)
    0x09, 0x31,                    //     USAGE (Y)
    0x09, 0x38,                    //     USAGE (Wheel)
    0x15, 0x81,                    //     LOGICAL_MINIMUM (-127)
    0x25, 0x7f,                    //     LOGICAL_MAXIMUM (127)
    0x75, 0x08,                    //     REPORT_SIZE (8)
    0x95, 0x03,                    //     REPORT_COUNT (2)
    0x81, 0x06,                    //     INPUT (Data,Var,Rel)
    0xc0,                          //     END_COLLECTION
    0xc0                           // END_COLLECTION
};
__code uint16_t CfgDescLen = sizeof(CfgDesc);

//String Descriptors
__code uint8_t LangDes[]={0x04,0x03,0x09,0x04};           //Language Descriptor
__code uint16_t LangDesLen = sizeof(LangDes);
__code uint16_t SerDes[]={                                 //Serial String Descriptor
    0x030C,
    'C','H','5','5','x',
};
__code uint16_t SerDesLen = sizeof(SerDes);
__code uint16_t Prod_Des[]={                                //Produce String Descriptor
    0x0316,
    '-','Y','u','a','n','-','3','k','e','y',
};
__code uint16_t Prod_DesLen = sizeof(Prod_Des);

__code uint16_t CDC_Des[]={
    0x0317,
    'Y','u','a','n','-','S','e','r','i','a','l',
};
__code uint16_t CDC_DesLen = sizeof(CDC_Des);

__code uint16_t Manuf_Des[]={    //SDCC is little endian
    0x030E,
    '-','Y','u','a','n','-',
};
__code uint16_t Manuf_DesLen = sizeof(Manuf_Des);
