yuan910715/3keys/(commit log)

2023-03-27 Update threekey.ino
    新增5键组合模式 新增三键同时按下设置
2023-03-27 Update README.md
    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
2023-08-28 增加备用改键地址https://yuan910715.github.io/3key/
2023-08-28 备用地址https://yuan910715.github.io/3key/
2023-11-03 Add PCB files
2025-03-19 固件压缩zip 解决烧录时报错问题
2025-04-03 更新说明
